OmarA664/ENCE-3231-Embedded-Systems/3_Wheel_Balance_Omar_Azzawi/balance_robot_report.docx

Three-Wheel Balance Robot

Embedded Systems — Project Report

STM32F407 Microcontroller Platform

Omar Azzawi • Embedded Systems

# Project Overview

Over the course of this semester I built and programmed an embedded robotics platform based on the STM32F407 microcontroller, working from a design and firmware provided by Dr. Martins. The project began with learning the STM32 development tools and the basics of programming the microcontroller. From there I captured the circuit schematic in KiCad and turned it into a custom PCB, which I then had manufactured. The final weeks of the course were spent soldering the components onto the board and working with the firmware.

The original goal was a self-balancing two-wheel robot. Because of time constraints, the platform was completed as a stable three-wheel robot that drives under wireless control. The hardware and firmware foundation needed for balancing are an IMU and a wheel encoder.

# Hardware Components

## STM32F407 Microcontroller

The STM32F407 is the brain of the robot. It runs all of the firmware, reads the sensors, generates the motor control signals, and handles wireless communication. Its many built-in timers and communication peripherals make it well suited to a motor-control project like this one.

## TB6612FNG Motor Driver

The TB6612FNG is a dual motor driver that sits between the microcontroller and the DC motors. The STM32 cannot supply enough current to drive motors directly, so the driver takes low-power direction and speed signals from the microcontroller and switches the higher motor current. Motor speed is set with a PWM signal and motor direction with a pair of digital control pins.

## MPU6050 Inertial Measurement Unit

The MPU6050 combines a three-axis accelerometer and a three-axis gyroscope on a single chip and communicates with the STM32 over the I2C bus. It measures the tilt and rotation of the robot, which is the information a balancing robot needs to know which way it is leaning. The accelerometer gives a stable long-term tilt reference while the gyroscope responds quickly to fast movements.

## MT6701 Magnetic Encoder

The MT6701 is a magnetic rotary encoder that measures wheel position and rotation speed, also over the I2C bus. Tracking how far and how fast a wheel turns is essential for controlling the robot's movement and, eventually, for keeping a balancing robot in place rather than drifting. Although all that is technically needed to stay upright is the IMU.

## WS2812 RGB LED and Wireless Module

A WS2812 addressable RGB LED provides visual status feedback, changing color to indicate the current command. A wireless module connected to the microcontroller's serial port receives driving commands from a phone app and passes them to the STM32, allowing the robot to be controlled remotely.

## Wireless Control

Driving commands arrive from the phone app through the wireless module as single characters over the serial connection. Each command is captured the moment it arrives and acted on in the main loop. The letters w, s, a, and d move the robot forward, backward, left, and right, while x stops it.

## Sensor Reading and Filtering

The firmware reads the inertial sensor about a hundred times per second and combines the accelerometer and gyroscope measurements using a complementary filter. This filter blends the steady accelerometer reading with the fast-responding gyroscope reading to produce a single smooth, accurate tilt angle.

## Telemetry and Status

Several times per second the robot reports its status back over the serial link, which is useful for monitoring and debugging. A status LED on the board blinks steadily to confirm the program is running normally.

# Firmware

The firmware ties all of the hardware together. At startup it initializes each peripheral; the motor driver, the inertial sensor, the encoder, the status LED, and the wireless serial link; and configures the timers that generate the motor PWM signals.
