OmarA664/ENCE-3231-Embedded-Systems/3_Wheel_Balance_Omar_Azzawi/KiCad/2026_Wheel_Balance_Robot_Omar/docs/PCB schematic.png

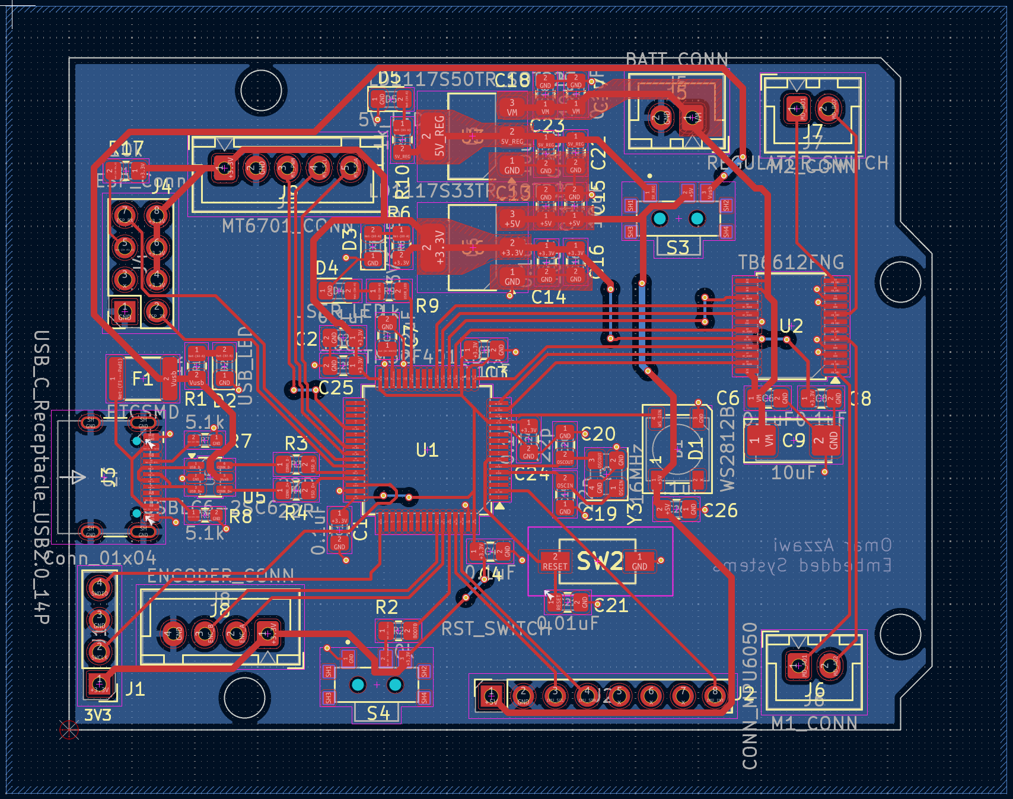
3_Wheel_Balance_Omar_Azzawi/KiCad/2026_Wheel_Balance_Robot_Omar/docs/PCB schematic.png
