OmarA664/ENCE-3231-Embedded-Systems/Lab1/Lab1 blockD.png

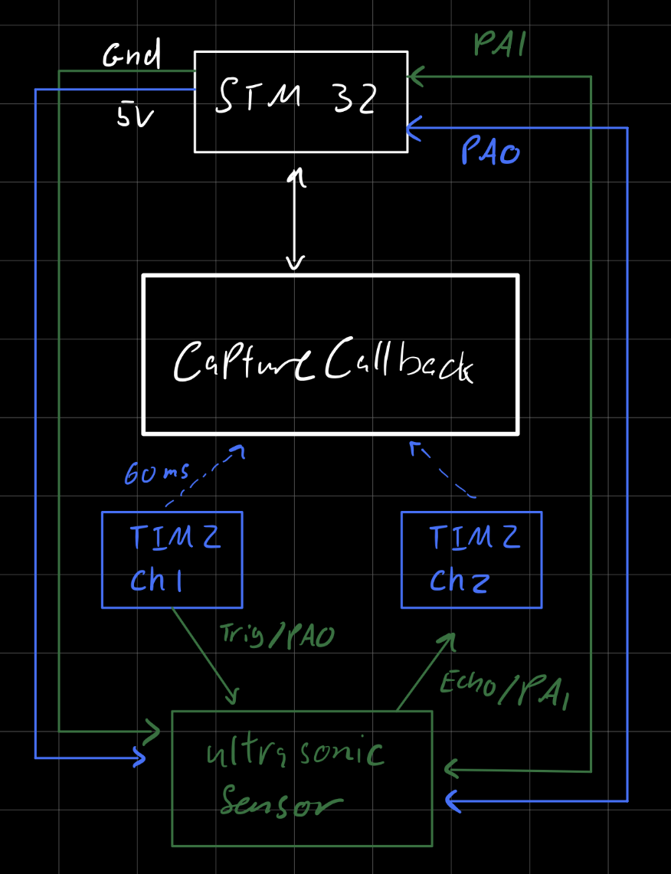
Lab1/Lab1 blockD.png
