OmarA664/ENCE-3231-Embedded-Systems/2026_12_2Wheel_Balance_Robot_v1/components/ESP8266-01_ESP-01/step/ESP8266-01_ESP-01.step

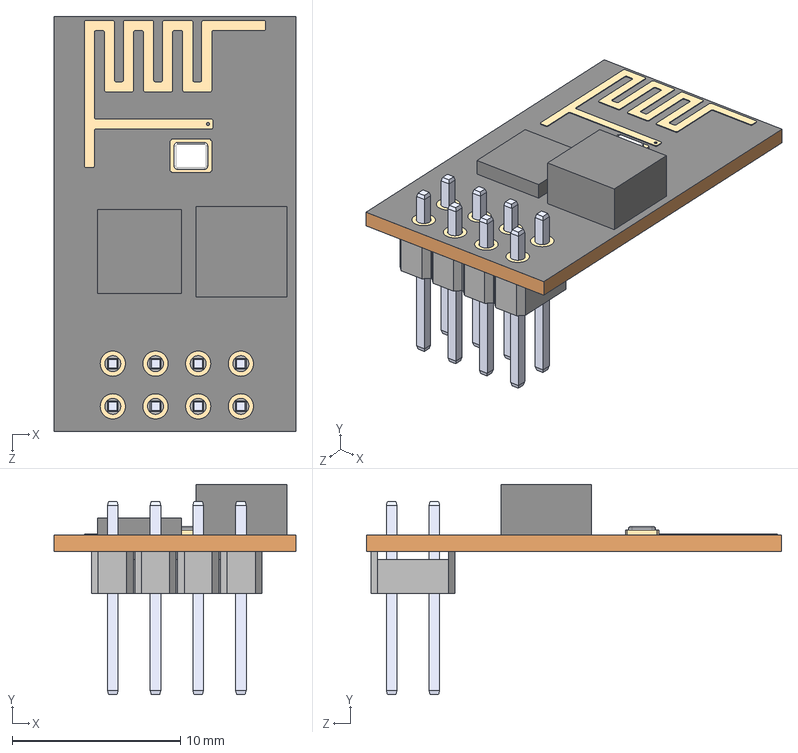
[picture p7: CAD file, 2026-06-09]
2026_12_2Wheel_Balance_Robot_v1/components/ESP8266-01_ESP-01/step/ESP8266-01_ESP-01.step
14.4 x 12.5 x 24.7 mm
