OmarA664/ENCE-3231-Embedded-Systems/2026_12_2Wheel_Balance_Robot_v1/components/Fuse_3DModel/MF-MSMF050-2--3DModel-STEP-56544.STEP

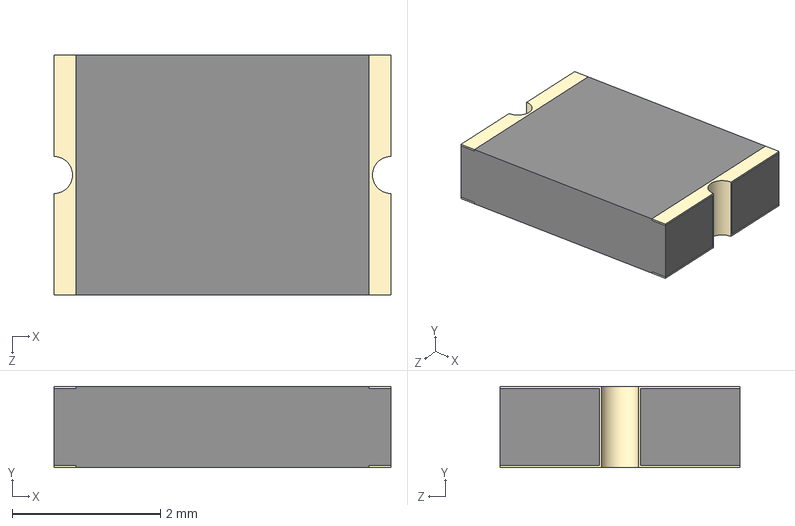
[picture p8: CAD file, 2026-06-09]
2026_12_2Wheel_Balance_Robot_v1/components/Fuse_3DModel/MF-MSMF050-2--3DModel-STEP-56544.STEP
4.55 x 1.10 x 3.24 mm
