OmarA664/ENCE-3231-Embedded-Systems/2026_12_2Wheel_Balance_Robot_v1/components/MPU6050/ITG-MPU.STEP

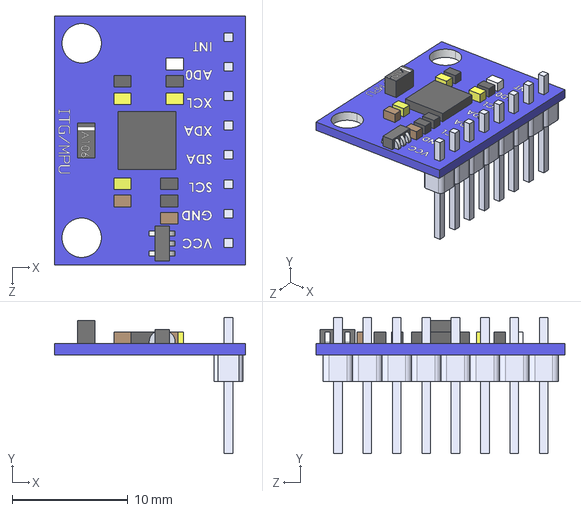
[picture p9: CAD file, 2026-06-09]
2026_12_2Wheel_Balance_Robot_v1/components/MPU6050/ITG-MPU.STEP
16.5 x 11.8 x 21.5 mm
8 Header-Pin
Placa_Base
