OmarA664/ENCE-3231-Embedded-Systems/2026_12_2Wheel_Balance_Robot_v1/components/SPDT_Slide_Switch/step/SLW-66527511-SMT-TR.step

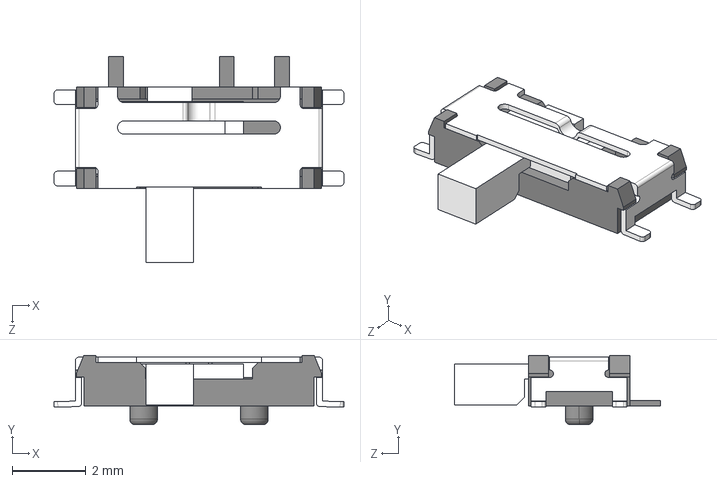
[picture p10: CAD file, 2026-06-09]
2026_12_2Wheel_Balance_Robot_v1/components/SPDT_Slide_Switch/step/SLW-66527511-SMT-TR.step
7.86 x 1.88 x 5.58 mm
