OmarA664/ENCE-3231-Embedded-Systems/2026_12_2Wheel_Balance_Robot_v1/components/SW_uP_Reset/step/SW_uP_Reset.stp

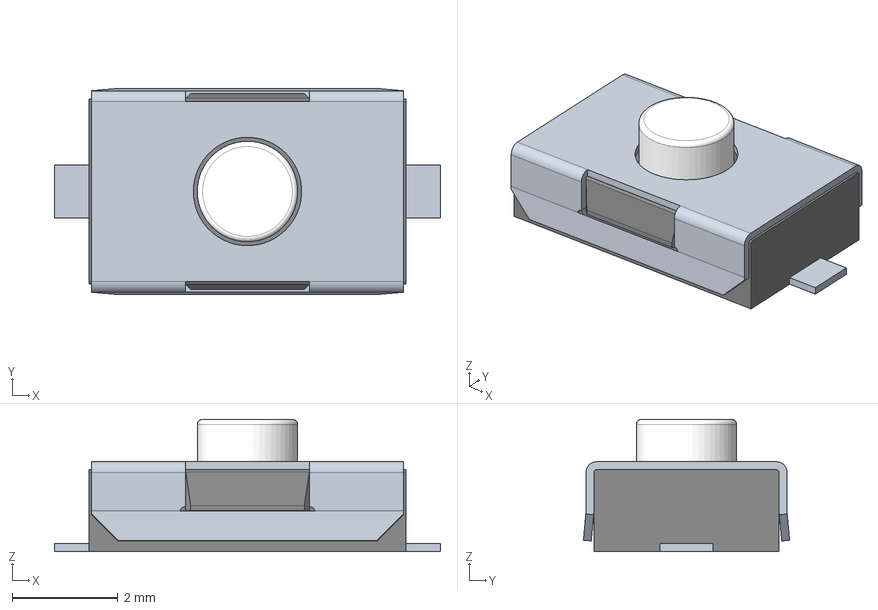
[picture p11: CAD file, 2026-06-09]
2026_12_2Wheel_Balance_Robot_v1/components/SW_uP_Reset/step/SW_uP_Reset.stp
7.30 x 3.90 x 2.50 mm
