OmarA664/ENCE-3231-Embedded-Systems/3_Wheel_Balance_Omar_Azzawi/CAD/Chassis_Omar_v2.dxf

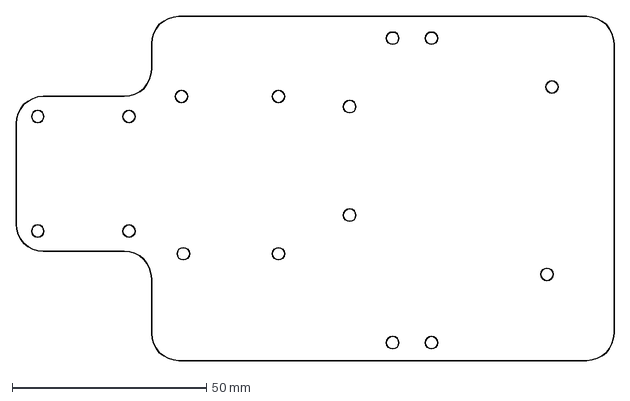
[picture p12: CAD file, 2026-06-09]
3_Wheel_Balance_Omar_Azzawi/CAD/Chassis_Omar_v2.dxf
154.0 x 88.6 mm
