OmarA664/ENCE-3231-Embedded-Systems/(list of files, cad)

Other CAD files:
3_Wheel_Balance_Omar_Azzawi/KiCad/2026_Wheel_Balance_Robot_Omar/components/ESP8266-01_ESP-01/step/ESP8266-01_ESP-01.step
3_Wheel_Balance_Omar_Azzawi/KiCad/2026_Wheel_Balance_Robot_Omar/components/Fuse_3DModel/MF-MSMF050-2--3DModel-STEP-56544.STEP
3_Wheel_Balance_Omar_Azzawi/KiCad/2026_Wheel_Balance_Robot_Omar/components/MPU6050/ITG-MPU.STEP
3_Wheel_Balance_Omar_Azzawi/KiCad/2026_Wheel_Balance_Robot_Omar/components/SPDT_Slide_Switch/step/SLW-66527511-SMT-TR.step
3_Wheel_Balance_Omar_Azzawi/KiCad/2026_Wheel_Balance_Robot_Omar/components/SW_uP_Reset/step/SW_uP_Reset.stp
