OmarA664/ENCE-3231-Embedded-Systems/3_Wheel_Balance_Omar_Azzawi/KiCad/2026_Wheel_Balance_Robot_Omar/2026_12_2Wheel_Balance_Robot_v1.kicad_pcb

## KiCad design 3_Wheel_Balance_Omar_Azzawi/KiCad/2026_Wheel_Balance_Robot_Omar/2026_12_2Wheel_Balance_Robot_v1.kicad_pcb (2026-06-09)


Parts:
C1, C2, C3, C4, C6, C8, C13, C14, C17, C22, C24, C26: 0.1uF; C_0805_2012Metric_Pad1.18x1.45mm_HandSolder; Mfr # C0805C104K4JACAUTO
C7: 2.2uF; C_0805_2012Metric_Pad1.18x1.45mm_HandSolder; Mfr # C0805X225K3RACAUTO
C9: 10uF; CP_EIA-6032-28_Kemet-C_HandSolder; Mfr # TPSC106M025R0500
C15, C16, C18, C23: 10uF; C_0805_2012Metric_Pad1.18x1.45mm_HandSolder; Mfr # C0805C106K4PACTU
C19, C20: 22p; C_0805_2012Metric_Pad1.18x1.45mm_HandSolder; Mfg Part# 08055C220KAT2A
C21: 0.01uF; C_0805_2012Metric_Pad1.18x1.45mm_HandSolder; Mfg Part# KAF21BR72A103JT
C25: 10uF; C_0805_2012Metric_Pad1.18x1.45mm_HandSolder; Mfg Part# C0805C106K4PACTU
D1: WS2812B; LED_WS2812B_PLCC4_5.0x5.0mm_P3.2mm; Mfr # FZ2812-5050; Mouser Digikey Part
D2: USB_LED; LED_0805_2012Metric_Pad1.15x1.40mm_HandSolder; Mfr # 150080BS75000
D3: 3V3_LED; LED_0805_2012Metric_Pad1.15x1.40mm_HandSolder; Mfr # 150080BS75000
D4: USER_LED; LED_0805_2012Metric_Pad1.15x1.40mm_HandSolder; Mfr # 150080BS75000
D5: 5V_LED; LED_0805_2012Metric_Pad1.15x1.40mm_HandSolder; Mfr # 150080BS75000
F1: PTCSMD; Fuse_1812_4532Metric; Mfr # MF-MSMF050-2
J1: Conn_01x04; PinHeader_1x04_P2.54mm_Vertical
J2: CONN_MPU6050; PinSocket_1x08_P2.54mm_Vertical
J3: USB_C_Receptacle_USB2.0_14P; USB_C_Receptacle_HCTL_HC-TYPE-C-16P-01A; Mfg Part# UJ20-C-H-C-4-SMT-TR
J4: ESP_Conn; PinSocket_2x04_P2.54mm_Vertical
J5: BATT_CONN; JST_XH_B2B-XH-A_1x02_P2.50mm_Vertical
J6: M1_CONN; JST_XH_B2B-XH-A_1x02_P2.50mm_Vertical
J7: M2_CONN; JST_XH_B2B-XH-A_1x02_P2.50mm_Vertical
J8: ENCODER_CONN; JST_XH_B4B-XH-A_1x04_P2.50mm_Vertical
J9: MT6701_CONN; JST_XH_B5B-XH-A_1x05_P2.50mm_Vertical
R1, R6, R9, R10: 1k; R_0805_2012Metric_Pad1.20x1.40mm_HandSolder; Mfr # TNPW08051K00FEEA
R2, R17: 10k; R_0805_2012Metric_Pad1.20x1.40mm_HandSolder; Mfr # CPF0805B10KE1
R3, R4: 22R; R_0805_2012Metric_Pad1.20x1.40mm_HandSolder; Mfr # RCA080522R0FKEA
R7, R8: 5.1k; R_0603_1608Metric_Pad0.98x0.95mm_HandSolder; Mfg Part# CRCW06035K10FKEC
S3: REGULATOR_SWITCH; SW_SLW-66527511-SMT-TR; PARTREV 1.01
S4: BOOT_SWITCH; SW_SLW-66527511-SMT-TR; PARTREV 1.01
SW2: SW_uP_Reset; Mfg Part# 434121025816
U1: STM32F401RBTx; LQFP-64_10x10mm_P0.5mm; Mfr # STM32F401RBT6
U2: TB6612FNG; SSOP-24_5.3x8.2mm_P0.65mm; Mfr # TB6612FNG,C,8,EL
U3: LD1117S50TR_SOT223; SOT-223-3_TabPin2; Mfr # LD1117S50TR
U5: USBLC6-2SC6; SOT-23-6; Mfr # USBLC6-2SC6
U6: LD1117S33TR_SOT223; SOT-223-3_TabPin2; Mfr # LD1117S33TR
Y3: 16MHz; Crystal_SMD_Abracon_ABM8G-4Pin_3.2x2.5mm; Mfg Part# ABM8-16.000MHZ-D1X-T

Connections:
5V_REG: C22.1, C23.1, R10.2, S3.1, U3.2 (VO)
+3.3V: C1.1, C2.1, C3.1, C4.1, C8.1, C14.1, C16.1, C24.1, C25.1, J1.1, J4.4, J4.6, J4.8, J8.1, J9.1, R6.2, R17.1, S4.3, U1.13 (VREF+), U1.19 (VDD), U1.32 (VDD), U1.48 (VDD), U1.64 (VDD), U2.20 (VCC), U6.2 (VO)
+5V: C13.1, C15.1, C26.2, D1.1 (VDD), J2.1, S3.2, U6.3 (VI)
/BOOT0: R2.2, U1.60 (BOOT0)
/CONN_D+: R4.1, U5.4 (I/O2)
/CONN_D-: R3.1, U5.6 (I/O1)
/ENC_A: J8.2, U1.59 (PB7)
/ENC_B: J8.3, U1.58 (PB6)
/ESD_D+: R4.2, U1.45 (USB_OTG_FS_DP)
/ESD_D-: R3.2, U1.44 (USB_OTG_FS_DM)
/ESP_RX: J4.7, U1.42 (USART1_TX)
/ESP_TX: J4.2, U1.43 (USART1_RX)
/IMU_INT: J2.8, U1.2 (PC13)
/IMU_SCL: J2.3, U1.61 (I2C1_SCL)
/IMU_SDA: J2.4, U1.62 (I2C1_SDA)
/MD_AIN1: U1.17 (PA3), U2.21 (AIN1)
/MD_AIN2: U1.16 (PA2), U2.22 (AIN2)
/MD_AO1: J6.1, U2.1 (AO1), U2.2 (AO1)
/MD_AO2: J6.2, U2.5 (AO2), U2.6 (AO2)
/MD_BIN1: U1.22 (PA6), U2.17 (BIN1)
/MD_BIN2: U1.23 (PA7), U2.16 (BIN2)
/MD_BO1: J7.1, U2.11 (BO1), U2.12 (BO1)
/MD_BO2: J7.2, U2.7 (BO2), U2.8 (BO2)
/MD_PWMA: U1.15 (TIM2_CH2), U2.23 (PWMA)
/MD_PWMB: U1.21 (TIM2_CH1), U2.15 (PWMB)
/MD_STBY: U1.20 (PA4), U2.19 (STBY)
/MT_PWM: J9.3, U1.37 (PC6)
/MT_SCL: J9.4, U1.41 (I2C3_SCL)
/MT_SDA: J9.5, U1.40 (I2C3_SDA)
/OSCIN: C19.2, U1.5 (RCC_OSC_IN), Y3.1
/OSCOUT: C20.2, U1.6 (RCC_OSC_OUT), Y3.3
/RESET: C21.1, SW2.2 (B), U1.7 (NRST)
/SWCLK: J1.2, U1.49 (SYS_JTCK-SWCLK)
/SWDIO: J1.4, U1.46 (SYS_JTMS-SWDIO)
/USB_D+: J3.A6 (D+), J3.B6 (D+), U5.3 (I/O2)
/USB_D-: J3.A7 (D-), J3.B7 (D-), U5.1 (I/O1)
/USER_LED: R9.2, U1.27 (PB1)
/WS_DIN: D1.4 (DIN), U1.14 (TIM5_CH1)
GND: C1.2, C2.2, C3.2, C4.2, C6.2, C7.2, C8.2, C9.2, C13.2, C14.2, C15.2, C16.2, C17.2, C18.2, C19.1, C20.1, C21.2, C22.2, C23.2, C24.2, C25.2, C26.1, D1.3 (VSS), D2.1 (K), D3.1 (K), D4.1 (K), D5.1 (K), J1.3, J2.2, J3.A1 (GND), J3.A12 (GND), J3.B1 (GND), J3.B12 (GND), J3.SH (SHIELD), J4.1, J5.2, J8.4, J9.2, R7.1, R8.2, S4.1, SW2.1 (A), U1.12 (VSSA), U1.18 (VSS), U1.28 (PB2), U1.31 (VSS), U1.47 (VSS), U1.63 (VSS), U2.3 (PGND1), U2.4 (PGND1), U2.9 (PGND2), U2.10 (PGND2), U2.18 (GND), U3.1 (GND), U5.2 (GND), U6.1 (GND), Y3.2, Y3.4
unnamed: D2.2 (A), R1.1
unnamed: D3.2 (A), R6.1
unnamed: D4.2 (A), R9.1
unnamed: D5.2 (A), R10.1
unnamed: F1.1, J3.A4 (VBUS), J3.A9 (VBUS), J3.B4 (VBUS), J3.B9 (VBUS)
unnamed: J3.A5 (CC1), R7.2
unnamed: J3.B5 (CC2), R8.1
unnamed: J4.5, R17.2
unnamed: R2.1, S4.2
unnamed: C7.1, U1.30 (VCAP1)
VM: C6.1, C9.1, C17.1, C18.1, J5.1, U2.13 (VM2), U2.14 (VM3), U2.24 (VM1), U3.3 (VI)
Vusb: F1.2, R1.2, S3.3, U5.5 (VBUS)

Notes on the sheet:
5V Selector Allows motors off and program board over USB
MT6701
SWD
MOTORS CONN
IMU (MPU6050)
MOTOR DRIVER
VOLTAGE REGULATORS
ENCODER
MICROCONTROLLER
PWR
ESP8266
VM = 15V (Max) Output Current: Iout=1.2A(ave)/3.2A(peak)
WS2812

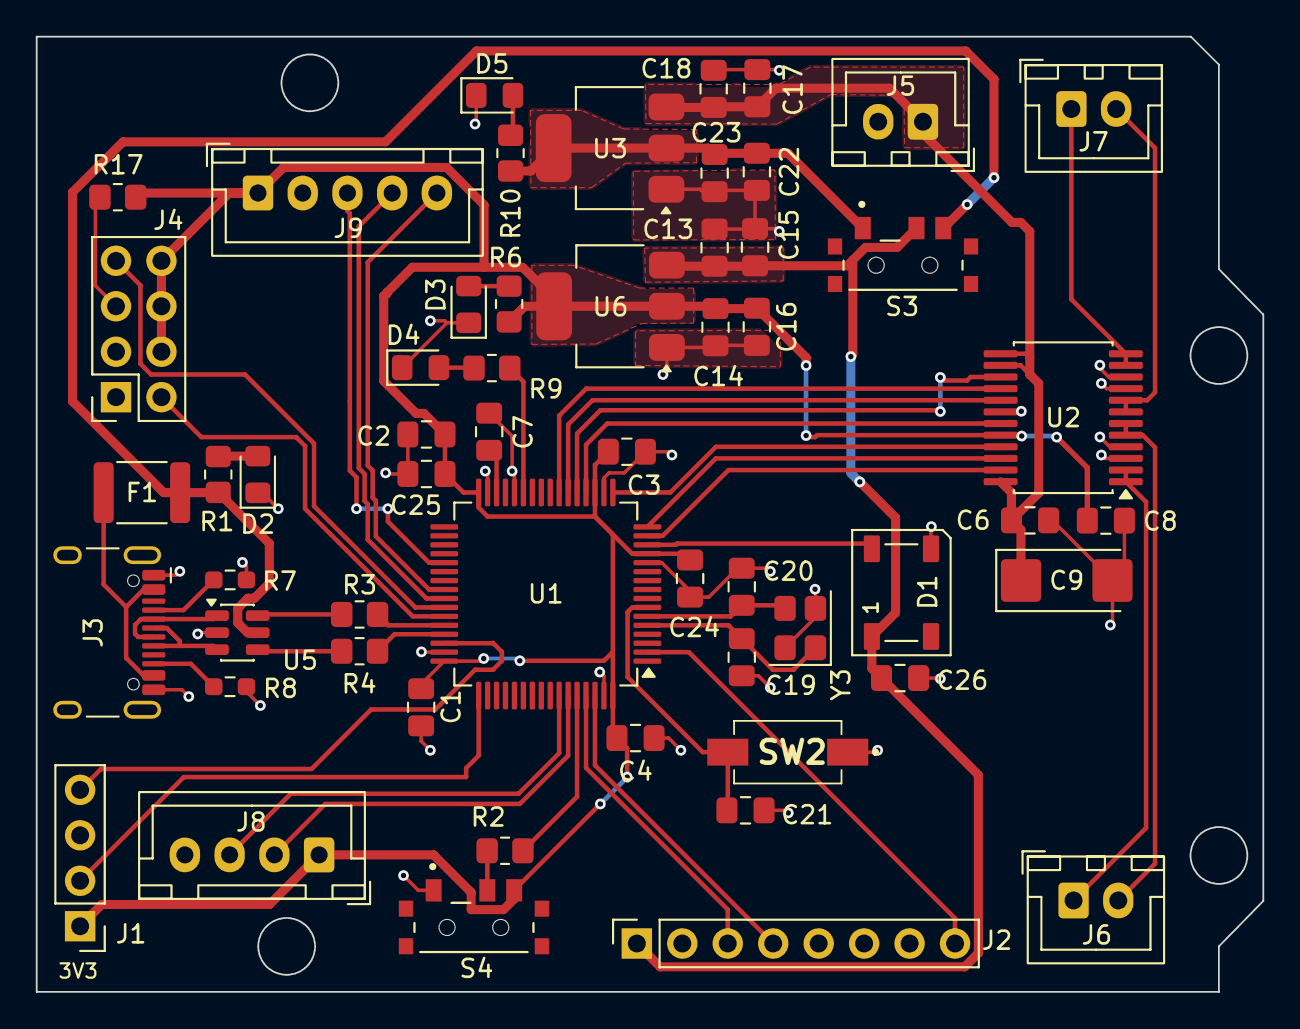
[picture p15: board 2026_12_2Wheel_Balance_Robot_v1.kicad_pcb from above]

Board: 2 copper layers, 68.6 x 53.4 mm, 56 parts (0 on the bottom side), 51 nets.
