OmarA664/ENCE-3231-Embedded-Systems/(commit log)

2026-06-09 Add 3-wheel balance robot project
    [2026_12_2Wheel_Balance_Robot_v1-B_Cu.gbr, 2026_12_2Wheel_Balance_Robot_v1-B_Mask.gbr, 2026_12_2Wheel_Balance_Robot_v1-B_Paste.gbr, 2026_12_2Wheel_Balance_Robot_v1-B_Silkscreen.gbr, 2026_12_2Wheel_Balance_Robot_v1-Edge_Cuts.gbr, 2026_12_2Wheel_Balance_Robot_v1-F_Cu.gbr, 2026_12_2Wheel_Balance_Robot_v1-F_Mask.gbr, 2026_12_2Wheel_Balance_Robot_v1-F_Paste.gbr]
2026-06-09 Move projecct into singlefolder
    [2026_12_2Wheel_Balance_Robot_v1-B_Cu.gbr, 2026_12_2Wheel_Balance_Robot_v1-B_Mask.gbr, 2026_12_2Wheel_Balance_Robot_v1-B_Paste.gbr, 2026_12_2Wheel_Balance_Robot_v1-B_Silkscreen.gbr, 2026_12_2Wheel_Balance_Robot_v1-Edge_Cuts.gbr, 2026_12_2Wheel_Balance_Robot_v1-F_Cu.gbr, 2026_12_2Wheel_Balance_Robot_v1-F_Mask.gbr, 2026_12_2Wheel_Balance_Robot_v1-F_Paste.gbr]
