OmarA664/ENCE-3231-Embedded-Systems/(notices)

Notices in the files:
3_Wheel_Balance_Omar_Azzawi/CODE/2026_STM32F401_3Wheel_Balance_noEncoder/Core/Src/main.c:
Copyright (c) 2026 STMicroelectronics.
All rights reserved.
This software is licensed under terms that can be found in the LICENSE file
